FredrikTheHuman/tbrpg/kjokkenvifte-klaff/forhandsvisning.png

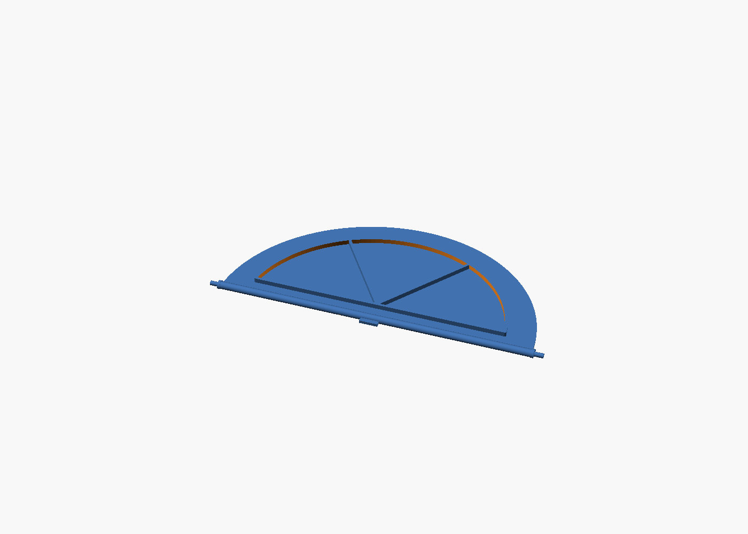
kjokkenvifte-klaff/forhandsvisning.png
