FredrikTheHuman/tbrpg/kjokkenvifte-klaff/maalesett.png

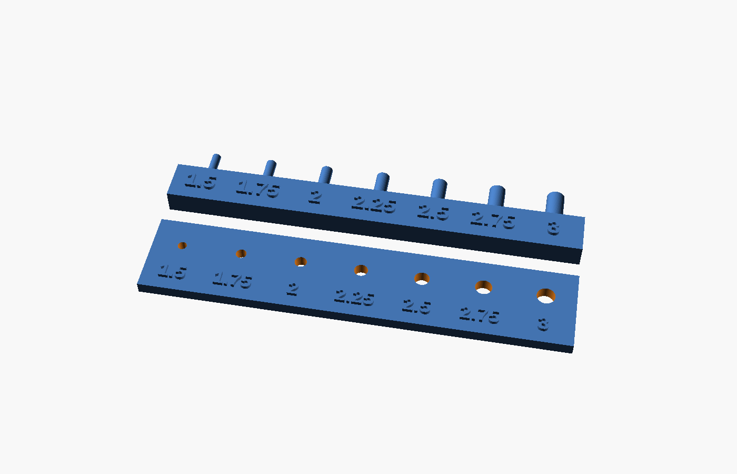
kjokkenvifte-klaff/maalesett.png
