FredrikTheHuman/tbrpg/kjokkenvifte-klaff/klaff_tapp_1.5.stl

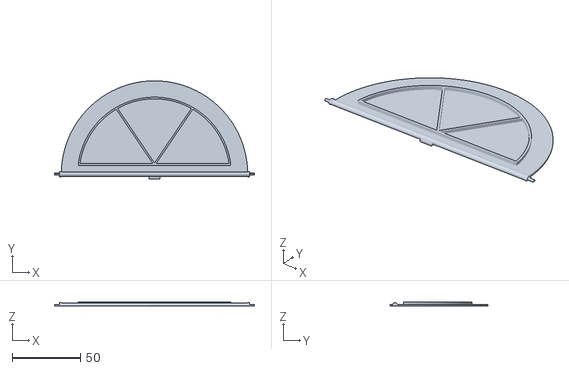
[picture p3: CAD file, 2026-10-21]
kjokkenvifte-klaff/klaff_tapp_1.5.stl
147.0 x 72.2 x 3.20
