FredrikTheHuman/tbrpg/kjokkenvifte-klaff/klaff_tapp_3.stl

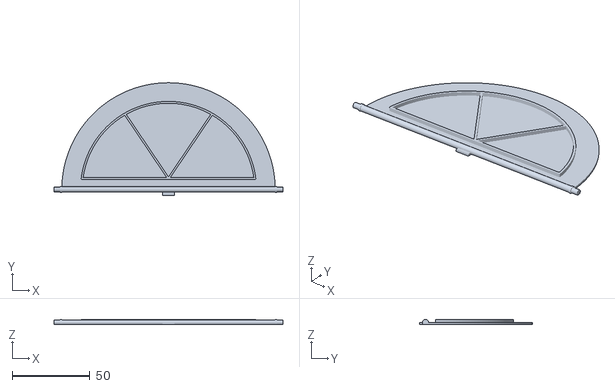
[picture p4: CAD file, 2026-10-21]
kjokkenvifte-klaff/klaff_tapp_3.stl
147.0 x 72.2 x 3.30
