FredrikTheHuman/tbrpg/kjokkenvifte-klaff/maalesett.stl

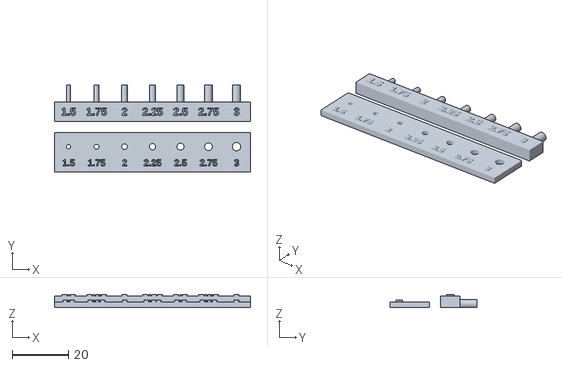
[picture p5: CAD file, 2026-10-21]
kjokkenvifte-klaff/maalesett.stl
70.0 x 31.0 x 4.59
