FredrikTheHuman/tbrpg/kjokkenvifte-klaff/klaff_staltrad.stl

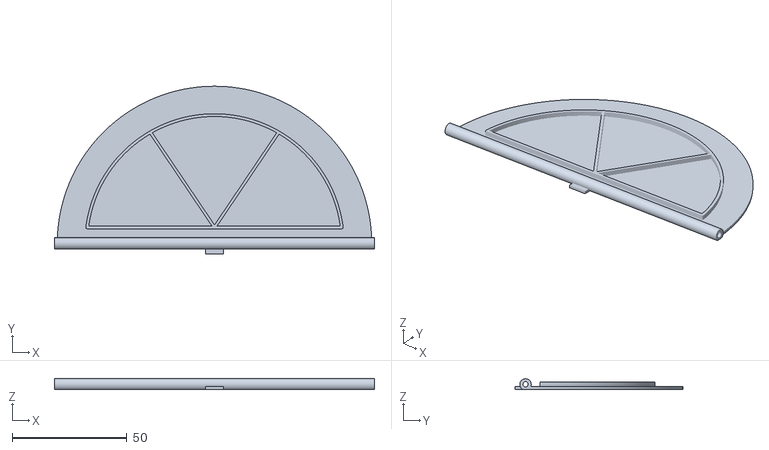
[picture p6: CAD file, 2026-10-21]
kjokkenvifte-klaff/klaff_staltrad.stl
139.4 x 73.0 x 4.60
