FredrikTheHuman/tbrpg/kjokkenvifte-klaff/klaff_printede_tapper.stl

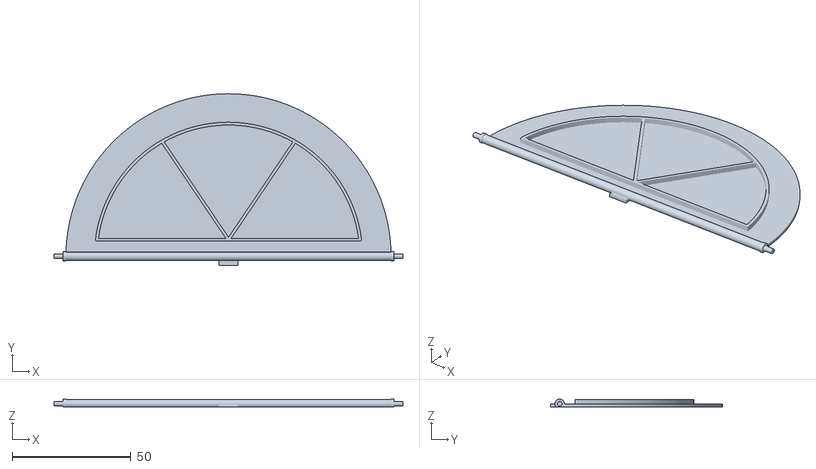
[picture p7: CAD file, 2026-10-21]
kjokkenvifte-klaff/klaff_printede_tapper.stl
147.0 x 72.2 x 3.35
