FredrikTheHuman/tbrpg/(list of files, cad)

Other CAD files:
kjokkenvifte-klaff/klaff_tapp_2.5.stl
kjokkenvifte-klaff/klaff_tapp_2.75.stl
kjokkenvifte-klaff/klaff_tapp_2.25.stl
kjokkenvifte-klaff/klaff_tapp_1.75.stl
kjokkenvifte-klaff/klaff_tapp_2.stl
