FredrikTheHuman/tbrpg/kjokkenvifte-klaff/Ny klaff til kjøkkenviften.pdf

# Ny klafftil kjøkkenviften – steg for steg

## Hva som skalfikses

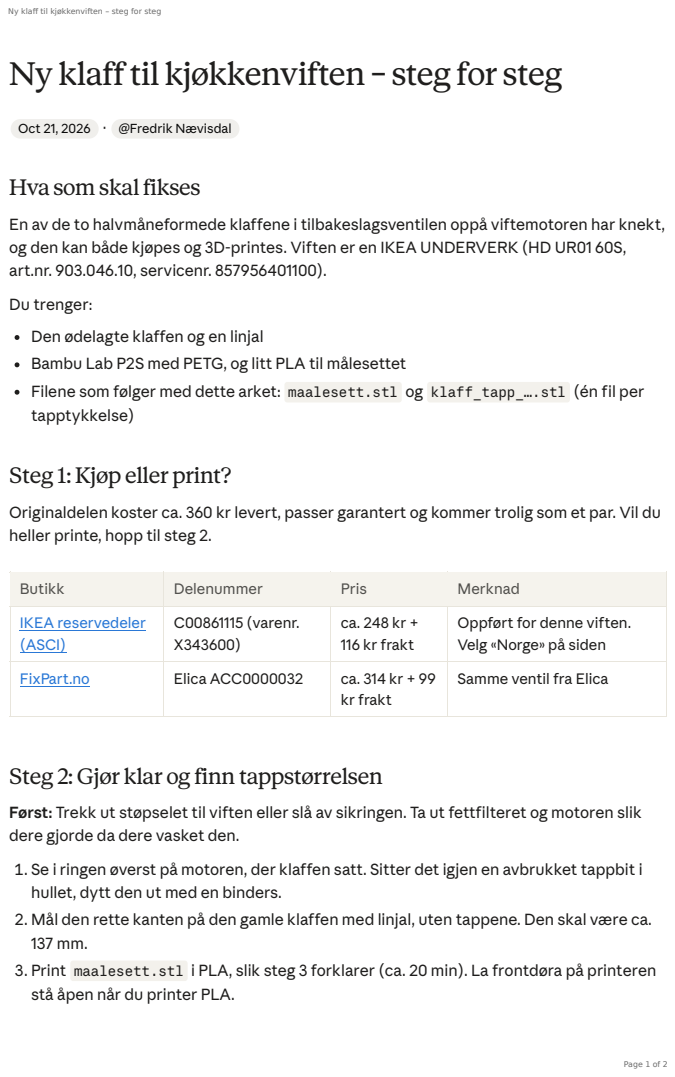
[picture p8: page 1]

Ny klaff til kjøkkenviften – steg for steg

Oct 21, 2026 · @Fredrik Nævisdal

En av de to halvmåneformede klaffene i tilbakeslagsventilen oppå viftemotoren har knekt,
og den kan både kjøpes og 3D-printes. Viften er en IKEA UNDERVERK (HD UR01 60S,
art.nr. 903.046.10, servicenr. 857956401100).
Du trenger:
Den ødelagte klaffen og en linjal
Bambu Lab P2S med PETG, og litt PLA til målesettet
Filene som følger med dette arket: maalesett.stl og klaff_tapp_….stl (én fil per
tapptykkelse)

Steg 1: Kjøp eller print?

Originaldelen koster ca. 360 kr levert, passer garantert og kommer trolig som et par. Vil du
heller printe, hopp til steg 2.

Butikk | Delenummer | Pris | Merknad
IKEA reservedeler (ASCI) (https://ikea.sparepartservice.shop/eshopmvc/articledetails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) | C00861115 (varenr. X343600) | ca. 248 kr + 116 kr frakt | Oppført for denne viften. Velg «Norge» på siden

FixPart.no (https://fixpart.no/produkt/elica-acc0000032-tilbakeslagsventil-kjokkenvifte) | Elica ACC0000032 | ca. 314 kr + 99 kr frakt | Samme ventil fra Elica

Steg 2: Gjør klar og finn tappstørrelsen

Først: Trekk ut støpselet til viften eller slå av sikringen. Ta ut fettfilteret og motoren slik
dere gjorde da dere vasket den.
1. Se i ringen øverst på motoren, der klaffen satt. Sitter det igjen en avbrukket tappbit i
hullet, dytt den ut med en binders.
2. Mål den rette kanten på den gamle klaffen med linjal, uten tappene. Den skal være ca.
3. Print maalesett.stl i PLA, slik steg 3 forklarer (ca. 20 min). La frontdøra på printeren
stå åpen når du printer PLA.

4. Hold kammen på høykant og stikk tappene én og én inn i det ledige hullet i ringen. Den tykkeste som går lett inn uten å klemme, er riktig. Tallet står ved tappen.
Har du hastverk, kan du hoppe over målesettet og printe klaff_tapp_2.stl direkte. Passer ikke tappene, bruk målesettet etterpå.

## Steg 3: Print klaffen

Print klaffen i PETG, som tåler varme bedre enn PLA. Velg filen med tallet kammen viste, for eksempel klaff_tapp_2.25.stl hvis 2.25 passet.
1. Dra STL-filen inn i Bambu Studio. Ikke snu eller flytt den: flat side ned, ribbene opp, ingen support.
2. Under Printer til venstre skal Plate type stå på «Textured PEI Plate». Det er platen som fulgte med, og den trenger ikke lim.
3. Velg filamentet som står på rullen, for eksempel Bambu PETG Basic (andre merker: «Generic PETG»).
4. Behold «0.20mm Standard». Under fanen Strength setter du Wall loops til 3.
5. Trykk Slice plate og så Print plate. Sjekk at AMS-sporet med riktig filament er valgt, og trykk Send.
6. La platen bli helt kald, ta den ut og bøy den lett så delen slipper.

## Steg 4: Monter og test

1. Snu den nye klaffen samme vei som den andre, med ribbene på samme side.
2. Sett den ene tappen helt inn i hullet. Bøy klaffen forsiktig i en bue til den andre tappen kommer forbi kanten, og la den gli inn i hullet. Ikke bøy mer enn nødvendig.
3. Vipp klaffen opp og slipp: den skal falle igjen og ligge an rundt hele kanten. Vipp begge klaffene helt opp: de skal ikke hekte i hverandre eller i ringen.
4. Sett motoren og filteret tilbake, slå på strømmen og kjør viften på høyeste trinn. Den skal trekke som før, uten å klapre.

## Hvis noe går galt

Tappene går ikke inn: print filen med ett tall tynnere, for eksempel 2 i stedet for 2.25. Klaffen rasler eller faller ut: print filen med ett tall tykkere.
Kanten er ikke ca. 137 mm: be den som ga deg filene om en ny fil med riktig mål (den lages i klaff.scad ).
Ingenting fungerer: bestill originaldelen i steg 1.

Ny klaff til kjøkkenviften – steg for steg
