FredrikTheHuman/tbrpg/(commit log)

2025-06-18 Install Express & Socket.io, add first public page
2026-10-21 Legg til STL-filer og forhåndsvisning av klaffen
    Claude-Session: https://claude.ai/code/session_01FMTrggX9mZueCxymUn5EVi
2026-10-21 Legg til printbart målesett for hengseltappene
    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
2026-10-21 Oppdater klaffen etter originalens mål og produktbilder
    Tapper med krage i begge ender, midtknast, Ø137 mm og 5 mm tapper.
    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
2026-10-21 Sett tappdiameter til 2 mm
    To uavhengige printbare klaffer for samme type 150 mm-ventil bruker ca. 2 mm tapper.
    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
2026-10-21 Fiks svevende tapper, ferdige filer per tapptykkelse
    - Tappene hviler nå på byggeplata (før svevde de 0.1-0.35 mm over)
    - Customizer: 0.25 mm-steg for pin_d, halve mm for diameter og pin_len
    - Wire-varianten: stangdiameter følger tråden, stang til kragelengde
    - Ferdige STL-er for tapp 1.75-3 mm, målesett 1.5-3 mm
    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
2026-10-21 Legg til 1.5 mm-variant og PDF av veiledningen
    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
